Rosemarychannan/Self_Balancing_Robot/Final_Product/README.md

This is the final version of the code for the self balancing robot. All requirements are met. It balances, and is able to go forwards and backwards, as well as turn in both directions.

bluetooth contains code for the bluetooth controller app flashed onto iphone. In conjunction with the code for the self balancing robot, we're able to tune and test values with ease

Circuit as follows:   
Screenshot 2025-06-21 at 12 10 08 AM
