Rosemarychannan/Self_Balancing_Robot/Final_Product/balance_only/README.md

This is the balancing code, using only the mcu and built-in sensor, the weight of encoders is added on the robot, however encoder is not used in the code at all
