Rosemarychannan/Self_Balancing_Robot/Self Balancing Robot ppt.pdf

# Self-Balancing Robot

- R O S E M A R Y C H A N

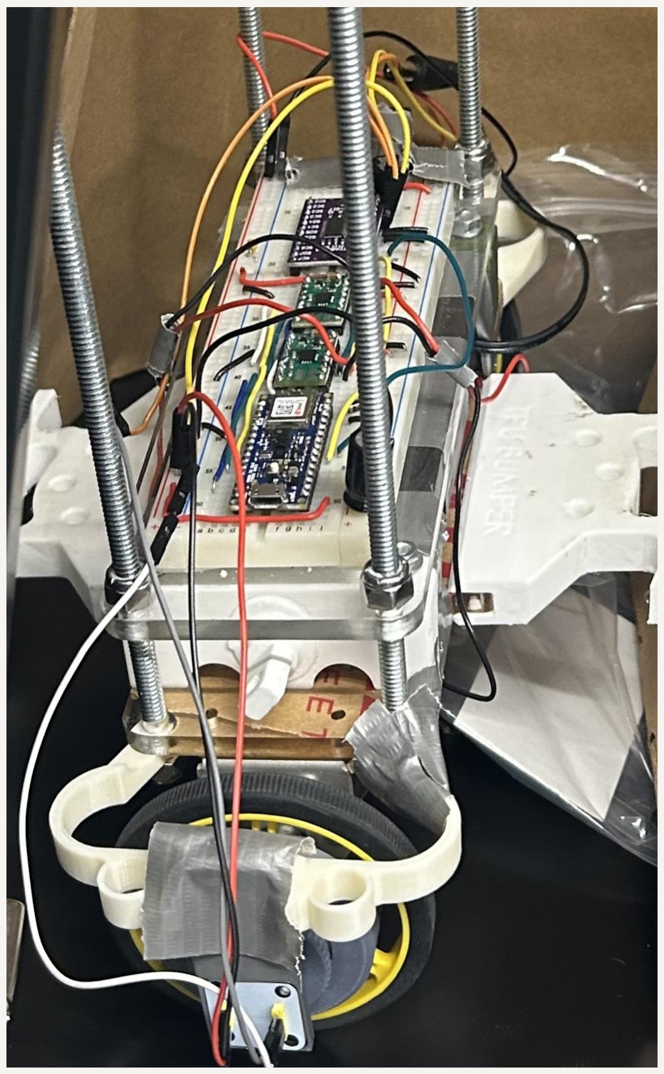
[picture p9: figure]

# Project Overview

- Designed and built a self-balancing two-wheeled robot
- 3-person team, brainstorm together and choose best implementation
- Objectives:
- Balance in place (±4 cm target)
- Move forward/backward 50 cm and pause
- Turn 45° and pause
- Climb a 10° ramp

7 / 9 / 2 0 2 5

# Hardware & Tools Used

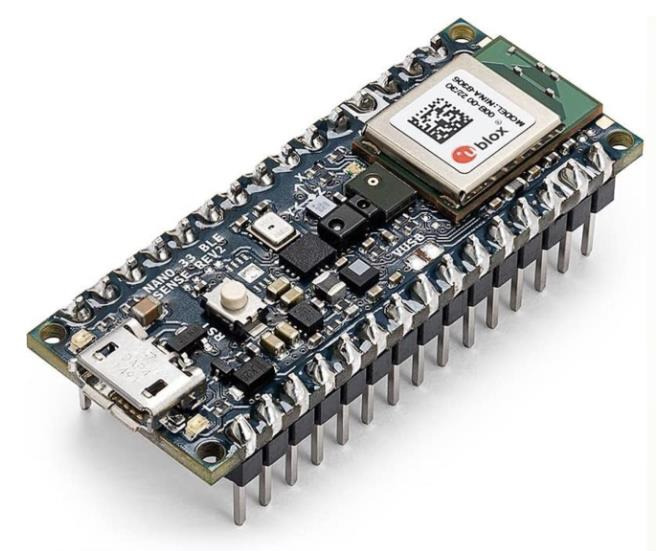
[picture p10: figure]

- Arduino Nano 33 BLE Sense Rev2 (NRF 52840 mcu)
- 2 × AS5600 magnetic encoders (via TCA9548A I²C mux)
- 2 × DRV8833 dual H-bridge motor drivers (paralleled)
- 3D-printed chassis + 8 × 1.5 V rechargeable batteries
- Flutter Bluetooth controller app
- Arduino IDE
- Oscilloscope, Multimeter, Power supply

# Angle & Velocity Sensing

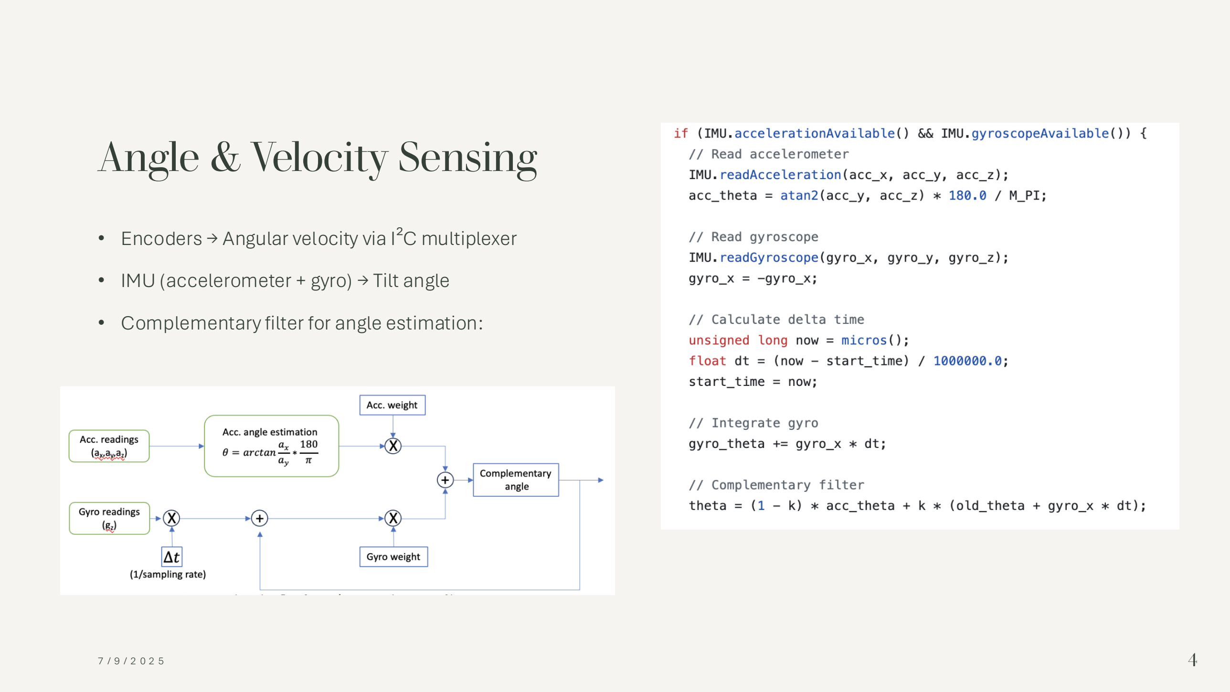
[picture p11: page 4]

- Encoders → Angular velocity via I²C multiplexer
- IMU (accelerometer + gyro) → Tilt angle
- Complementary filter for angle estimation:

# PWM Motor Control

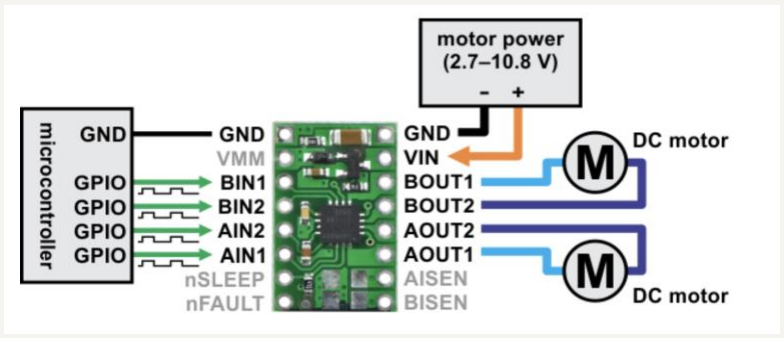
[picture p12: figure]

- Arduino outputs PWM to H-bridges
- Vary duty cycle → set motor speed
- Offset wheel speeds to turn

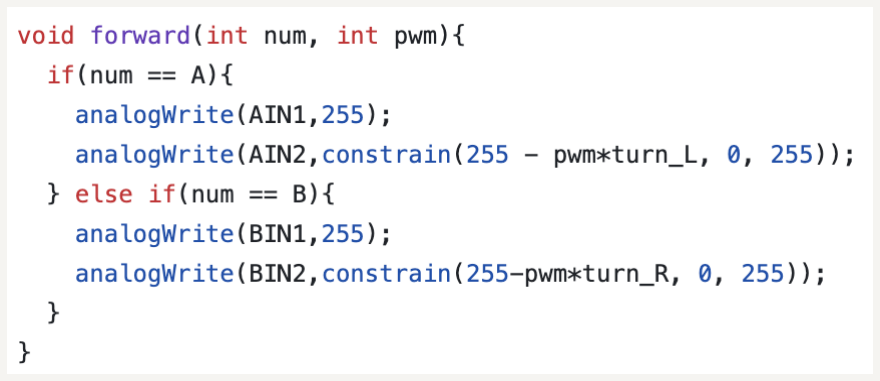
[picture p13: figure]

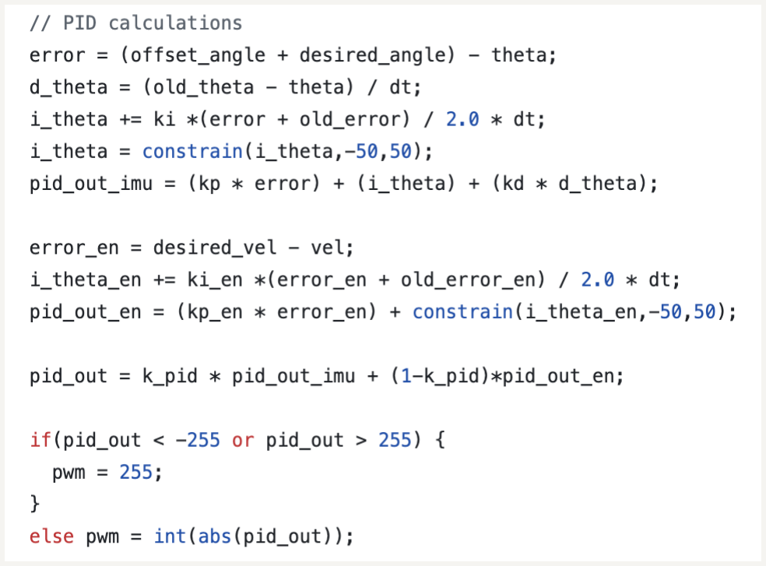
[picture p14: figure]

# Balancing PID

- Compute error = θ_measured – θ_setpoint (0°).
- PID → PWM (0–255).
- Sign of PID output → forward/backward direction; magnitude → speed.

# Forward/Backward Motion

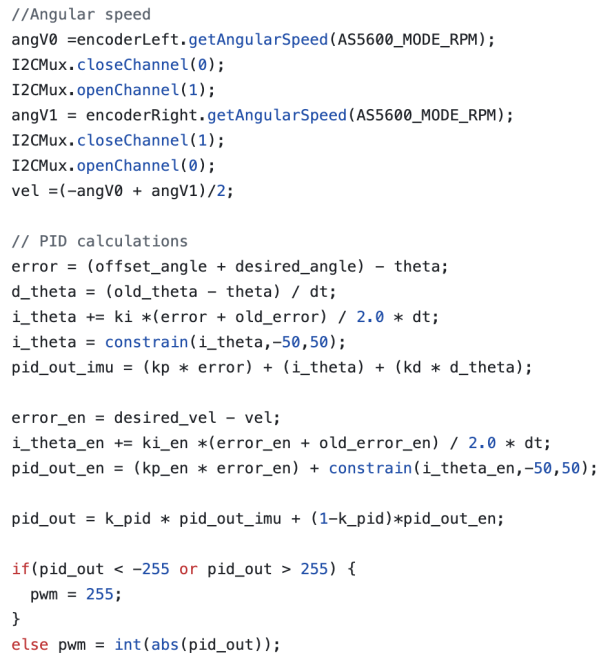
[picture p15: figure]

Version 1: Weighted PWM Blend
- Compute velocity error → PWM.
- Blend with balance-PID PWM: pwm_final = k*pwm_balance + (1–k)*pwm_velocity.
- Problem: tendency to accelerate forever to maintain tilt → eventual tip-over.

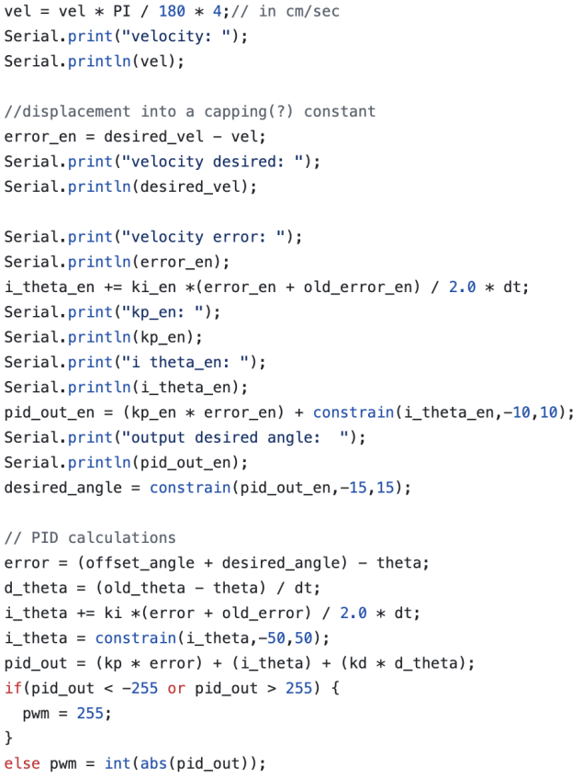
[picture p16: figure]

Version 2: Cascaded PID
| Outer PID: velocity error → desired
| tilt angle.
| Inner PID: balance using that tilt
| setpoint.
| Result: smooth, steady motion and
| proper pauses.

# Turning

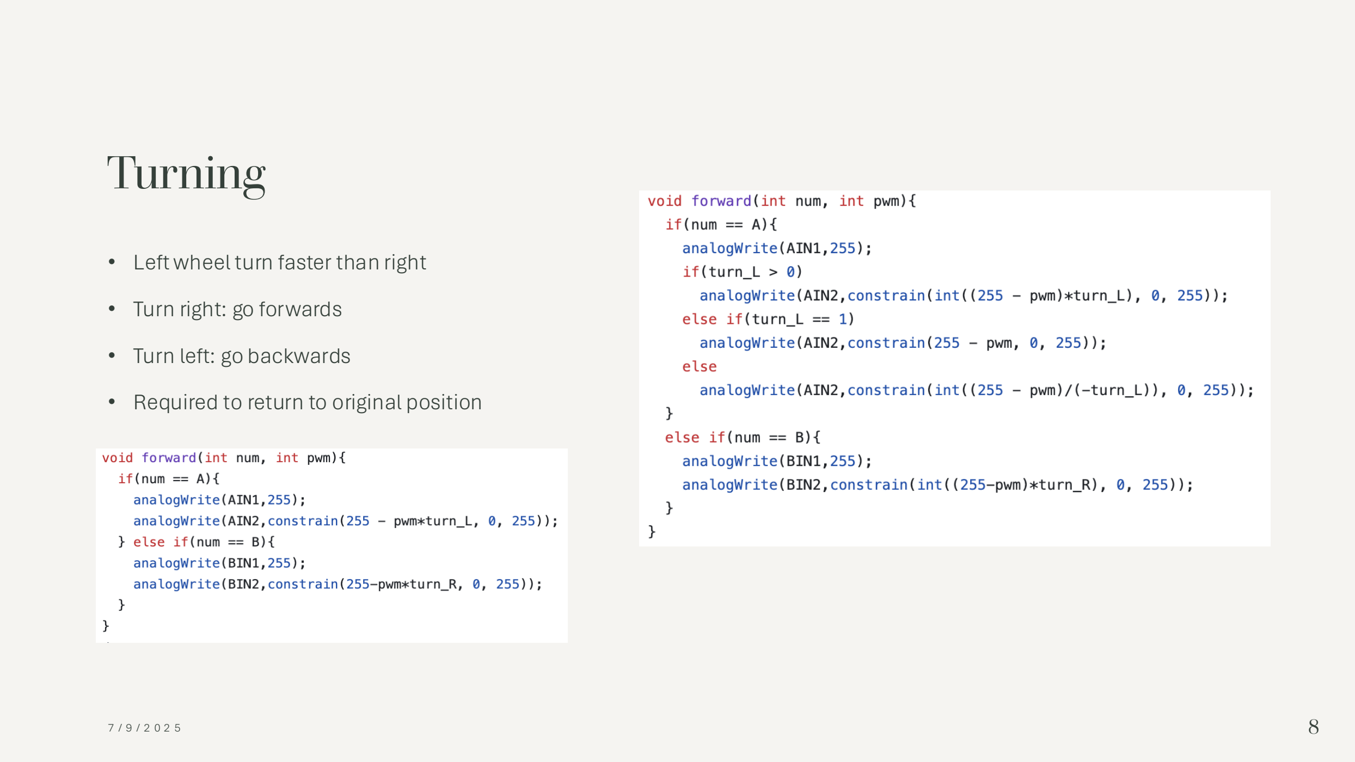
[picture p17: page 8]

- Left wheel turn faster than right
- Turn right: go forwards
- Turn left: go backwards
- Required to return to original position

# Testing

Sensor Validation | Wheel Characterization | Simulink Modeling

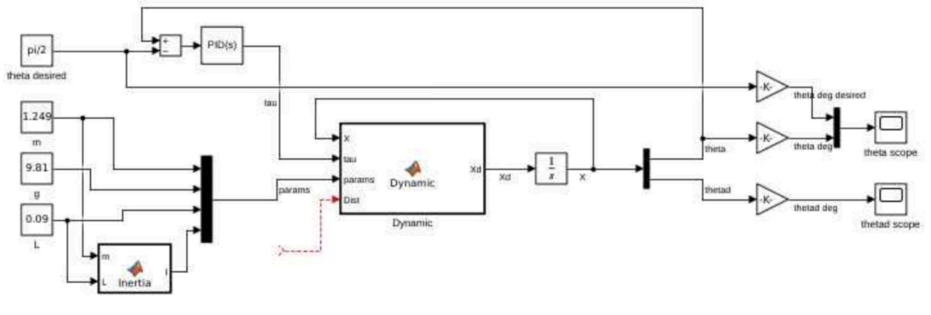
[picture p18: figure]

# Tuning

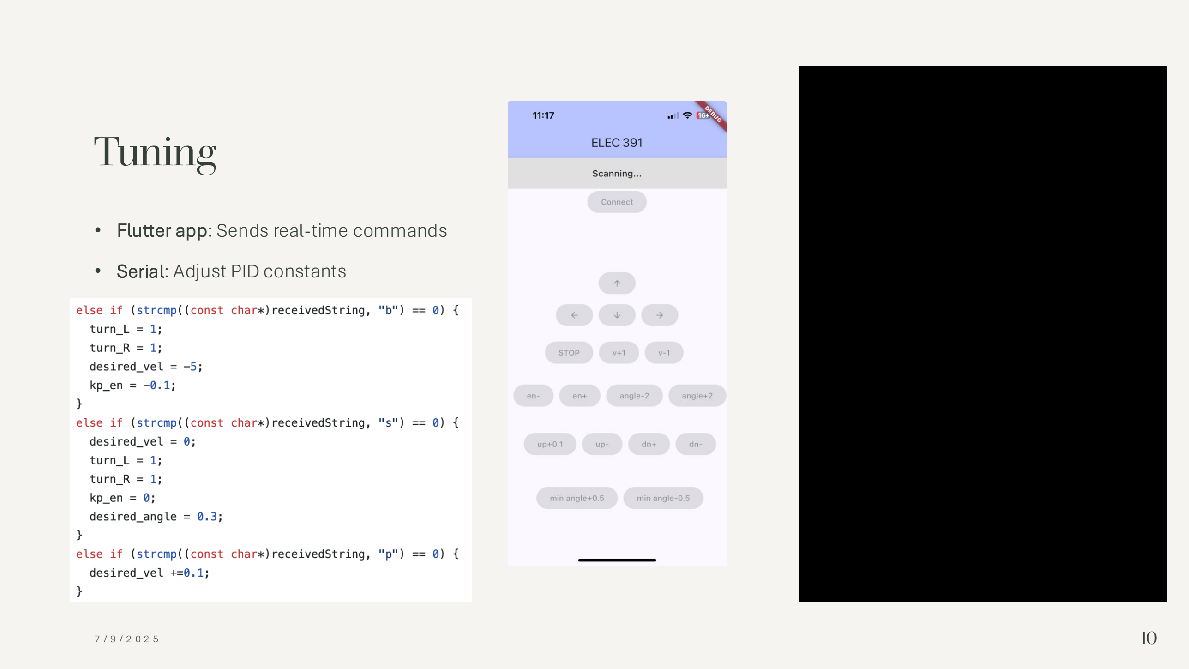
[picture p19: page 10]

- Flutter app: Sends real-time commands
- Serial: Adjust PID constants

# Final Results

- Balanced within ±2 cm (goal: ±4 cm)
- Moved 50 cm & paused correctly
- Turned 45° with minimal overshoot
- Climbed a 10° ramp

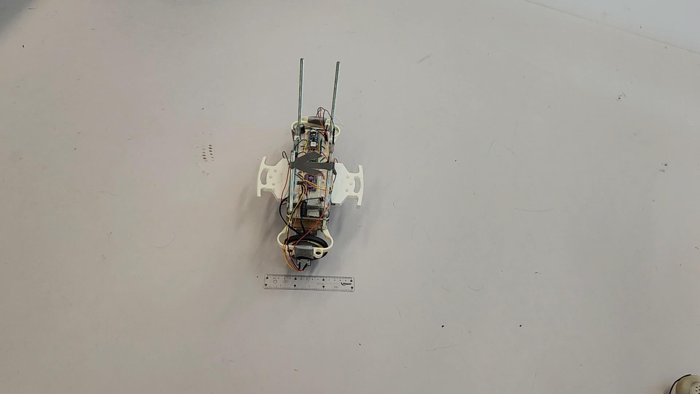
[picture p20: page 12]

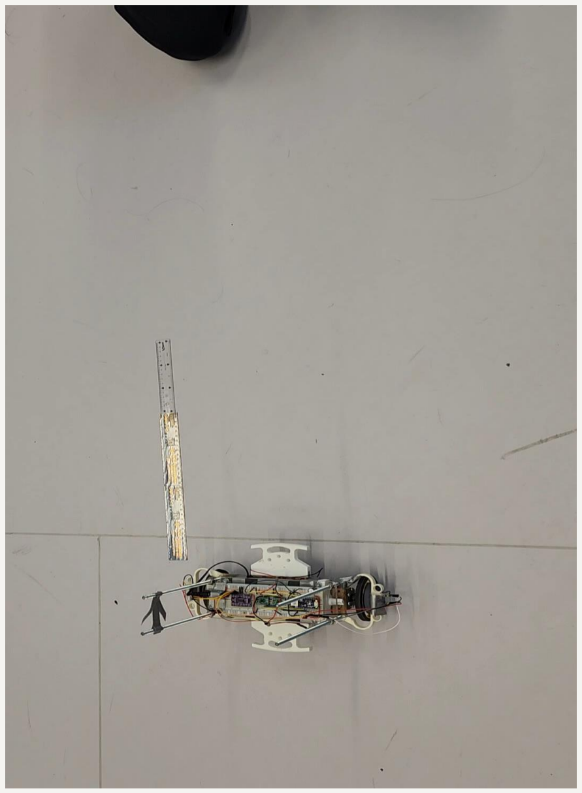
[picture p21: figure]

# Challenges & Lessons

- Offset errors due to battery level, chassis bumps
- Wheel differences required compensation factors
- Final night: loose screw caused slipping → retuned everything at 3 AM

# Future Improvements

- Organize and clean up code
- Use timer for autonomous motion

# Links:

-Full project (https://github.com/Rosemarychannan/Self_Balancing_Robot/tree/main)

(https://github.com/Rosemarychannan/Self_Balancing_Robot/tree/main)
-Angle test (https://github.com/Rosemarychannan/Self_Balancing_Robot/tree/main/Starter_Assignment)

(https://github.com/Rosemarychannan/Self_Balancing_Robot/tree/main/Starter_Assignment)
-Prototype pwm (https://github.com/Rosemarychannan/Self_Balancing_Robot/tree/main/Prototype))

(https://github.com/Rosemarychannan/Self_Balancing_Robot/tree/main/Prototype)
-Final code (https://github.com/Rosemarychannan/Self_Balancing_Robot/tree/main/Final_Product)

(https://github.com/Rosemarychannan/Self_Balancing_Robot/tree/main/Final_Product)

# THANK YOU
