Rosemarychannan/Self_Balancing_Robot/(commit log)

2025-06-18 Update Final_Product.ino
    encoderrrr
2025-06-18 Create Cascaded_pid.ino
    different approach on pid
2025-06-21 Technical presentation power point for the project
